Conectando-Cosas-2022/Smart-Cowork/README.md

# Smart-Cowork
Proyecto Integrador 2 - Grupo 3
