Conectando-Cosas-2022/Smart-Cowork/Documentación/Smart cowork - banner.pdf

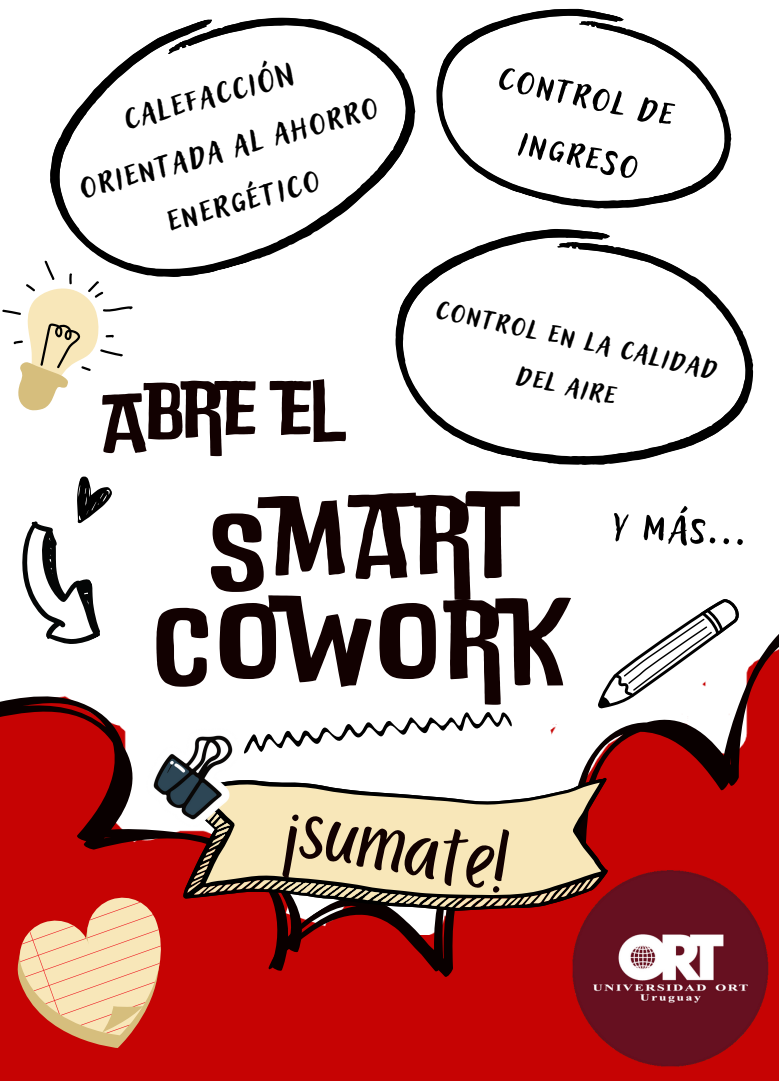
[picture p32: page 1]
Smart cowork; Abre el; ¡sumate!; CalefacciÓN; energético; del aire; Control de; ingreso; Y MÁS...

orientada al ahorro

control en la calidad
