Conectando-Cosas-2022/Smart-Cowork/(commit log)

2022-11-17 Edita función callback
    Agrega funciones para el prendido y apagado de la bomba, que responden a los llamados RPC.
    Modulariza la publicación de atributos a Thingsboard.
2022-11-17 Codigo placa piso 1
    Conecta a WIFI, lee temperatura ambiente con el sensor DHT22 de forma asincrónica, reporta telemetria con temperatura ambiente a Thingsboard
2022-11-17 Agrega lectura RFID
    Realiza lectura RFID en el loop y reporta un string con los valores hexadecimales del tag leido
2022-11-17 Integracion de las pruebas piso0
    Actuadores: bomba y caldera
    Sensores: temperatura del agua
    Reporta telemetria de los sensores a thingsboard, recibe llamados RPC para cambiar el estado de los actuadores y reporta los atributos correspondientesa su estado a thingsboard
2022-12-11 cambio de pines a correctos, probado y funcionando
    [placa_piso0.ino, placa_piso1.ino]
2022-12-11 corrige error de abrir y cerrar ventanta
    [placa_piso1.ino]
2022-12-12 agrego metodos callback para abrir y cerrar puerta
2022-12-12 agrega metodos en la funcion callback para el control del smartfilm
2022-12-13 Rule chains
